GavMacA/Sound-Level-Meter/doc/Components_List.xlsx

Complétez tous les champs
Composants disponibles en salle de TP : résistances et condensateurs standards, AOP LM741, indiquez seulement la valeur et la quantité souhaitée
Fournisseurs : Radiospares (https://fr.rs-online.com/web/) OU Farnell (fr.farnell.com)
Numéro de binôme : 3 |  | Groupe de TD : 1
Fournissseur | Dénomination | Référence | Code commande | Quantité | Stock restant
 | Résistance 100k |  |  | 5
 | Résistance 400 |  |  | 5
 | Résistance 3.3k |  |  | 3
 | Résistance 1.5k |  |  | 1
 | Résistance 820 |  |  | 1
 | Résistance 8.2k |  |  | 1
 | Résistance 82k |  |  | 1
 | Résistance 1k |  |  | 4
 | Résistance 1Meg |  |  | 3
 | Résistance 130k |  |  | 1
 | Résistance 6.8k |  |  | 1
 | Résistance 2k |  |  | 1
 | Résistance 10k |  |  | 2
 | Résistance 20k |  |  | 2
 | Potentiomètre 1k |  |  | 1
 | Condensateur 22uF |  |  | 4
 | Condensateur 10uF |  |  | 1
RS | Schotky Diode 1N5817 | Redresseur Schottky STMicroelectronics Diode Schottky Simple, 20 V, , 1 A Traversant 2 broches DO-41 | 189-4375 | 50 | 550
RS | LED Rouge | LED, Kingbright 2 broches, Traversant Rouge 625 nm, 5 V 60 ° L53, 5 mm (T-1 3/4) | 228-5562 | 5 | .
RS | LED Jaune | LED, Kingbright 2 broches, Traversant Jaune 588 nm, 2.1 V 60 ° L53, 5 mm | 228-6010 | 5 | .
RS | LED Verte | LED, Kingbright 2 broches, Traversant Vert 568 nm, 2 V 60 ° L53, 5 mm (T-1 3/4) | 228-6004 | 5 | .
RS | Transistor 2N2907 | Transistor onsemi, -800 mA PnP, -60 V, 3 broches, TO-92 Simple | 739-0492 | 10 | 500
RS | Transistor 2N2222 | Transistor onsemi, 1 A NPN, 40 V, 3 broches, TO-92 Simple | 739-0381 | 15 | 920
RS | Transistor J113 | JFET onsemiCanal-Type N, Canal-JFET, Simple 2 mA, 3 broches TO-92 | 806-1766 | 5 | 100
RS | Connecteur de batterie 9V | Contact de batterie Goujon pression 9 V RS PRO | 185-4788 | 1 | 754
RS | Connecteur à vis | Bloc de jonction CI série CTB0509 3 contacts RS PRO Vertical pas de 5.08 mm Traversant 1 rangée(s) | 146-8346 | 4 | 130
