GavMacA/Sound-Level-Meter/kicad/sound_level_meter.kicad_pcb

## KiCad design kicad/sound_level_meter.kicad_pcb (2026-07-21)

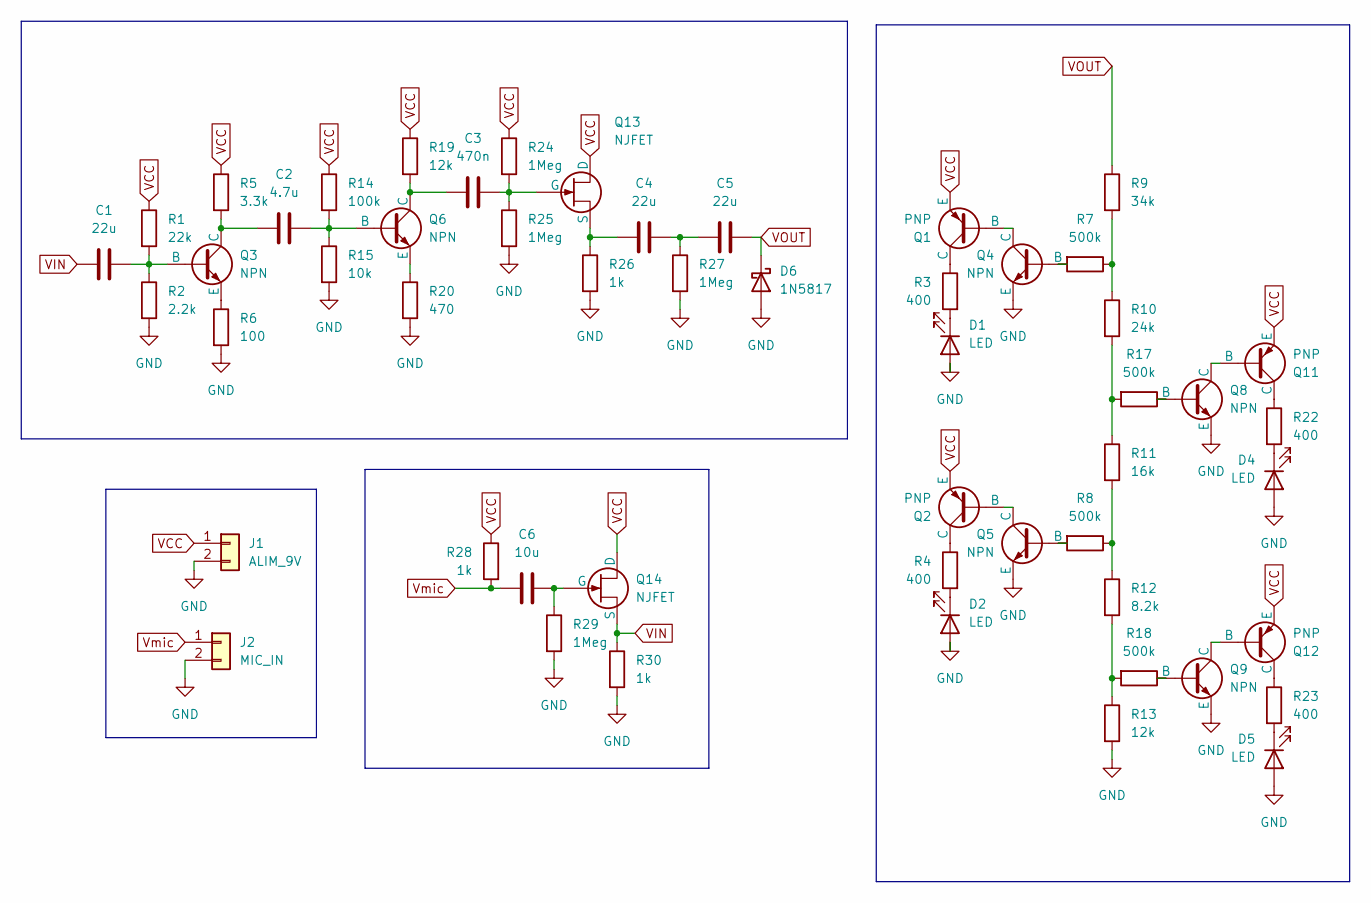
[picture p32: schematic sound_level_meter.kicad_sch]

Parts:
C1, C4, C5: 22u; CP_Radial_D5.0mm_P2.50mm
C2: 4.7u; CP_Radial_D5.0mm_P2.00mm
C3: 470n; C_Rect_L7.2mm_W2.5mm_P5.00mm
C6: 10u; CP_Radial_D5.0mm_P2.50mm
D1, D2, D4, D5: LED; LED_D5.0mm
D6: 1N5817; D_DO-41_SOD81_P10.16mm_Horizontal
J1: ALIM_9V; TerminalBlock_CUI_TB007-508-02_1x02_P5.08mm_Horizontal
J2: MIC_IN; TerminalBlock_CUI_TB007-508-02_1x02_P5.08mm_Horizontal
Q1, Q2, Q11, Q12: PNP; TO-18-3
Q3, Q4, Q5, Q6, Q8, Q9: NPN; TO-18-3
Q13, Q14: NJFET; TO-92_Inline
R1: 22k; R_Axial_DIN0207_L6.3mm_D2.5mm_P7.62mm_Horizontal
R2: 2.2k; R_Axial_DIN0207_L6.3mm_D2.5mm_P7.62mm_Horizontal
R3, R4, R22, R23: 400; R_Axial_DIN0207_L6.3mm_D2.5mm_P7.62mm_Horizontal
R5: 3.3k; R_Axial_DIN0207_L6.3mm_D2.5mm_P7.62mm_Horizontal
R6: 100; R_Axial_DIN0207_L6.3mm_D2.5mm_P7.62mm_Horizontal
R7, R8, R17, R18: 500k; R_Axial_DIN0207_L6.3mm_D2.5mm_P7.62mm_Horizontal
R9: 34k; R_Axial_DIN0207_L6.3mm_D2.5mm_P7.62mm_Horizontal
R10: 24k; R_Axial_DIN0207_L6.3mm_D2.5mm_P7.62mm_Horizontal
R11: 16k; R_Axial_DIN0207_L6.3mm_D2.5mm_P7.62mm_Horizontal
R12: 8.2k; R_Axial_DIN0207_L6.3mm_D2.5mm_P7.62mm_Horizontal
R13, R19: 12k; R_Axial_DIN0207_L6.3mm_D2.5mm_P7.62mm_Horizontal
R14: 100k; R_Axial_DIN0207_L6.3mm_D2.5mm_P7.62mm_Horizontal
R15: 10k; R_Axial_DIN0207_L6.3mm_D2.5mm_P7.62mm_Horizontal
R20: 470; R_Axial_DIN0207_L6.3mm_D2.5mm_P7.62mm_Horizontal
R24, R25, R27, R29: 1Meg; R_Axial_DIN0207_L6.3mm_D2.5mm_P7.62mm_Horizontal
R26, R28, R30: 1k; R_Axial_DIN0207_L6.3mm_D2.5mm_P7.62mm_Horizontal

Connections:
GND: D1.2 (A), D2.2 (A), D4.2 (A), D5.2 (A), D6.2 (A), J1.2, J2.2, Q4.3 (E), Q5.3 (E), Q8.3 (E), Q9.3 (E), R2.2, R6.2, R13.2, R15.2, R20.2, R25.2, R26.2, R27.2, R29.2, R30.2
unnamed: C4.2, C5.1, R27.1
unnamed: D1.1 (K), R3.2
unnamed: D2.1 (K), R4.2
unnamed: D4.1 (K), R22.2
unnamed: D5.1 (K), R23.2
unnamed: Q1.2 (B), Q4.1 (C)
unnamed: Q1.1 (C), R3.1
unnamed: Q2.2 (B), Q5.1 (C)
unnamed: Q2.1 (C), R4.1
unnamed: C1.2, Q3.2 (B), R1.2, R2.1
unnamed: C2.1, Q3.1 (C), R5.2
unnamed: Q3.3 (E), R6.1
unnamed: Q4.2 (B), R7.2
unnamed: Q5.2 (B), R8.2
unnamed: C2.2, Q6.2 (B), R14.2, R15.1
unnamed: C3.1, Q6.1 (C), R19.2
unnamed: Q6.3 (E), R20.1
unnamed: Q8.2 (B), R17.1
unnamed: Q9.2 (B), R18.1
unnamed: Q8.1 (C), Q11.2 (B)
unnamed: Q11.1 (C), R22.1
unnamed: Q9.1 (C), Q12.2 (B)
unnamed: Q12.1 (C), R23.1
unnamed: C3.2, Q13.2 (G), R24.2, R25.1
unnamed: C4.1, Q13.3 (S), R26.1
unnamed: C6.2, Q14.2 (G), R29.1
unnamed: R7.1, R9.2, R10.1
unnamed: R10.2, R11.1, R17.2
unnamed: R8.1, R11.2, R12.1
unnamed: R12.2, R13.1, R18.2
VCC: J1.1, Q1.3 (E), Q2.3 (E), Q11.3 (E), Q12.3 (E), Q13.1 (D), Q14.1 (D), R1.1, R5.1, R14.1, R19.1, R24.1, R28.1
VIN: C1.1, Q14.3 (S), R30.1
VOUT: C5.2, D6.1 (K), R9.1
Vmic: C6.1, J2.1, R28.2

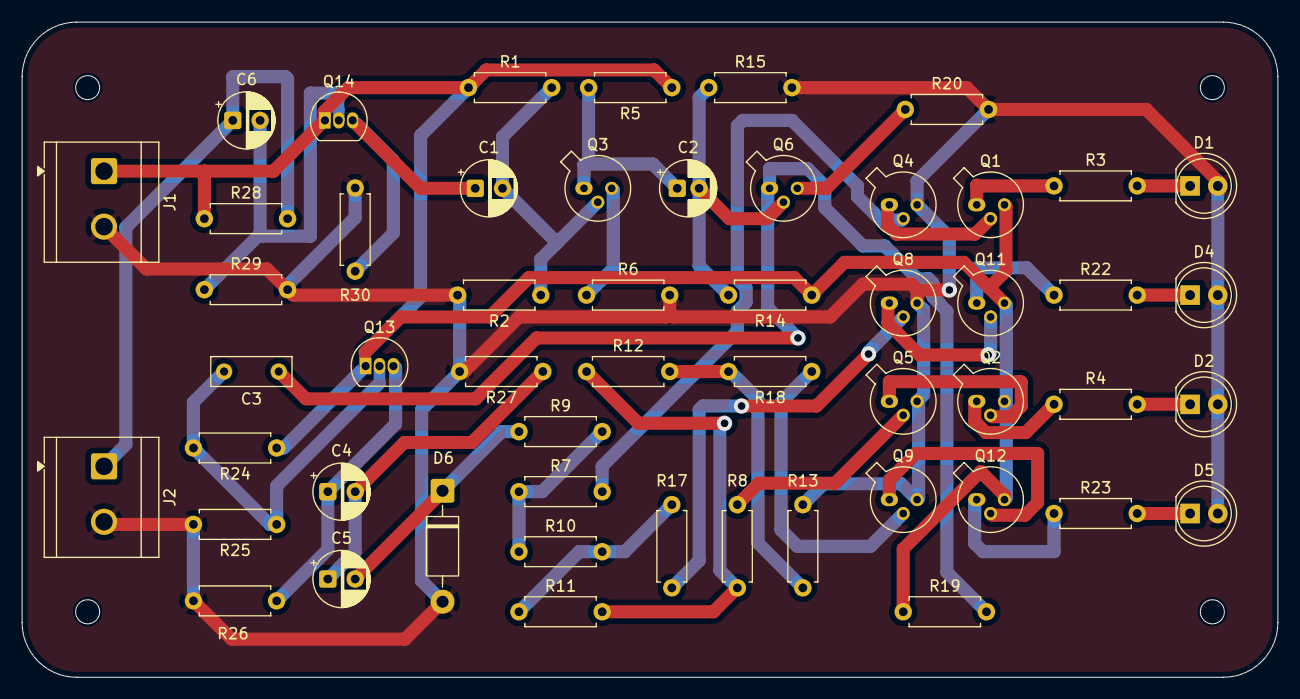
[picture p33: board sound_level_meter.kicad_pcb from above]

Board: 2 copper layers, 115.0 x 60.0 mm, 53 parts (0 on the bottom side), 35 nets.
