GavMacA/Sound-Level-Meter/(commit log)

2026-07-21 Update PCB images in README.md
2026-07-21 Update PCB labels in README.md to English
2026-07-21 Add PCB images to README
2026-07-21 Update PCB image reference in README
2026-07-21 Update PCB section title in README
2026-07-21 Update image syntax for PCB in README
2026-07-21 Add Sonometre PCB image
2026-07-21 Update PCB image format from PNG to JPEG
2026-07-21 Rename Projet2_EC.kicad_pcb to KiCad Files/Projet2_EC.kicad_pcb
    [Projet2_EC.kicad_pcb]
2026-07-21 Rename Projet2_EC.kicad_pro to KiCad Files/Projet2_EC.kicad_pro
2026-07-21 Rename Projet2_EC.kicad_sch to KiCad Files/Projet2_EC.kicad_sch
    [Projet2_EC.kicad_sch]
2026-07-21 Add sound_level_meter.kicad_pcb file
    [sound_level_meter.kicad_pcb]
2026-07-21 Add sound_level_meter.kicad_pro file
2026-07-22 Revise README with schematic and key concepts
    Updated the README to include schematic details and related concepts.
